mohamedelwalid/esp32-battlebot-control/(commit log)

2026-07-12 Update README with project details and documentation
    Added detailed project overview, electronics setup, system architecture, and testing procedures for the BattleBot ESP32 control system.
2026-07-12 Refine README.md for clarity and conciseness
    Updated README.md to improve clarity and conciseness throughout the document, including sections on control flow, testing, limitations, and project context.
2026-07-12 Revise README for improved project documentation
    Updated README.md to enhance clarity and detail regarding the BattleBot project, including sections on electronics, power protection, control flow, and testing results.
2026-07-12 Revise README for clarity and updated visuals
    Updated README with new images, improved descriptions, and clarified wiring and PCB sections.
2026-07-12 Refactor README image formatting and fix filename
    Updated README to replace image markdown with HTML for better formatting and corrected PCB layout filename.
2026-07-12 Revise README for improved clarity and detail
    Updated README.md for clarity and detail in project description, features, electronics, control flow, and contributions.
